neryosorio/AutoGreen/documentacion/circuito_fisico.jpeg

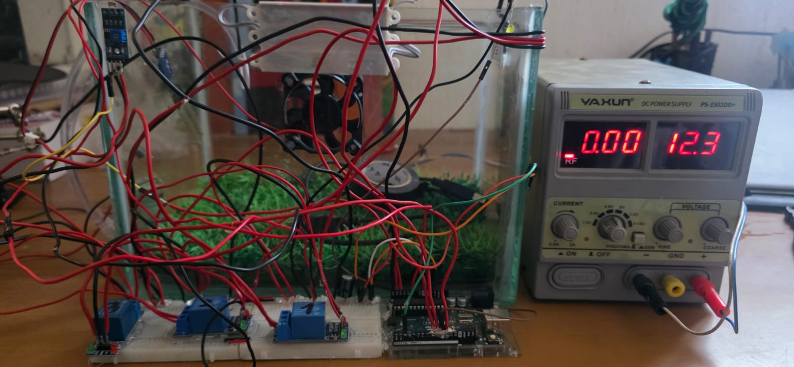
documentacion/circuito_fisico.jpeg
