neryosorio/AutoGreen/(commit log)

2026-06-02 Fix: corregir estructura del archivo de codigo fuente
2026-06-03 Agregar captura de simulacion en SimulIDE
2026-06-03 Fix: eliminar ciclos intermitentes en bomba y ventilador
    [AutoGreen.ino]
2026-06-03 Agregar foto del circuito fisico
